bikerglen/pic24-dmx-rgb-led-dimmer/(list of files, cad)

Other CAD files:
mech/pic24-rgb-led-strip-tilt-bracket-v4.f3d
