bikerglen/pic24-dmx-rgb-led-dimmer/boards/open-din-rail-mount/pic24rgbdin-01.pdf

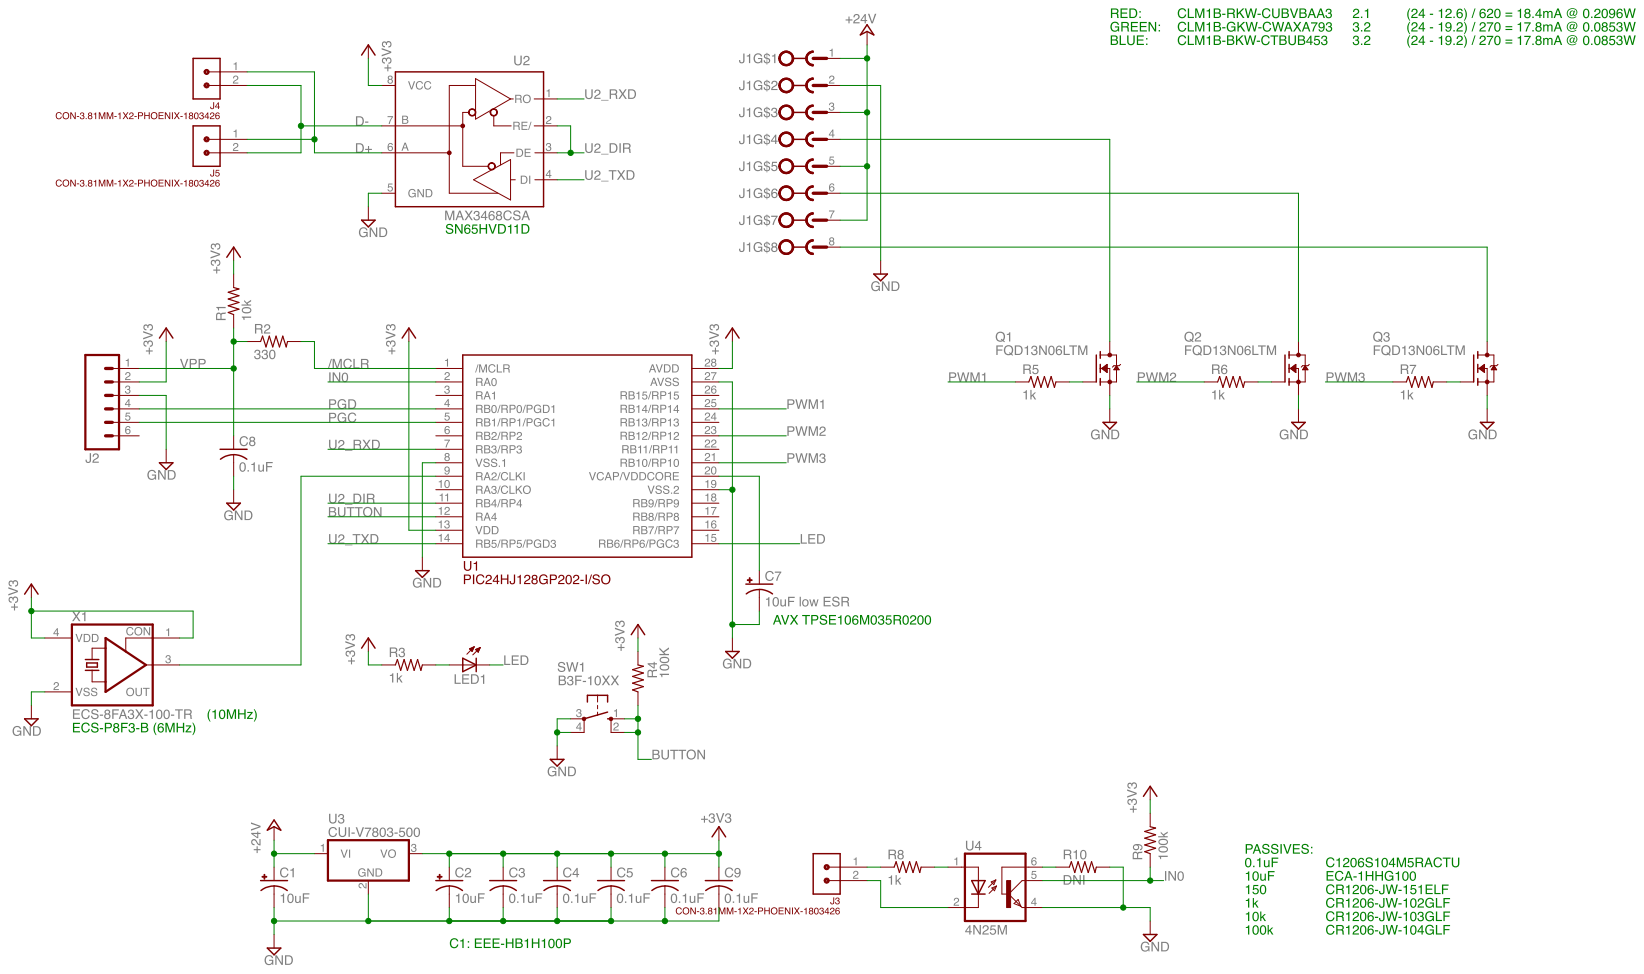
[picture p1: page 1]
