bikerglen/pic24-dmx-rgb-led-dimmer/boards/two-inch-round-v2/pic24rgbrnd01-r2b.brd

## EAGLE design boards/two-inch-round-v2/pic24rgbrnd01-r2b.brd (2019-03-25)

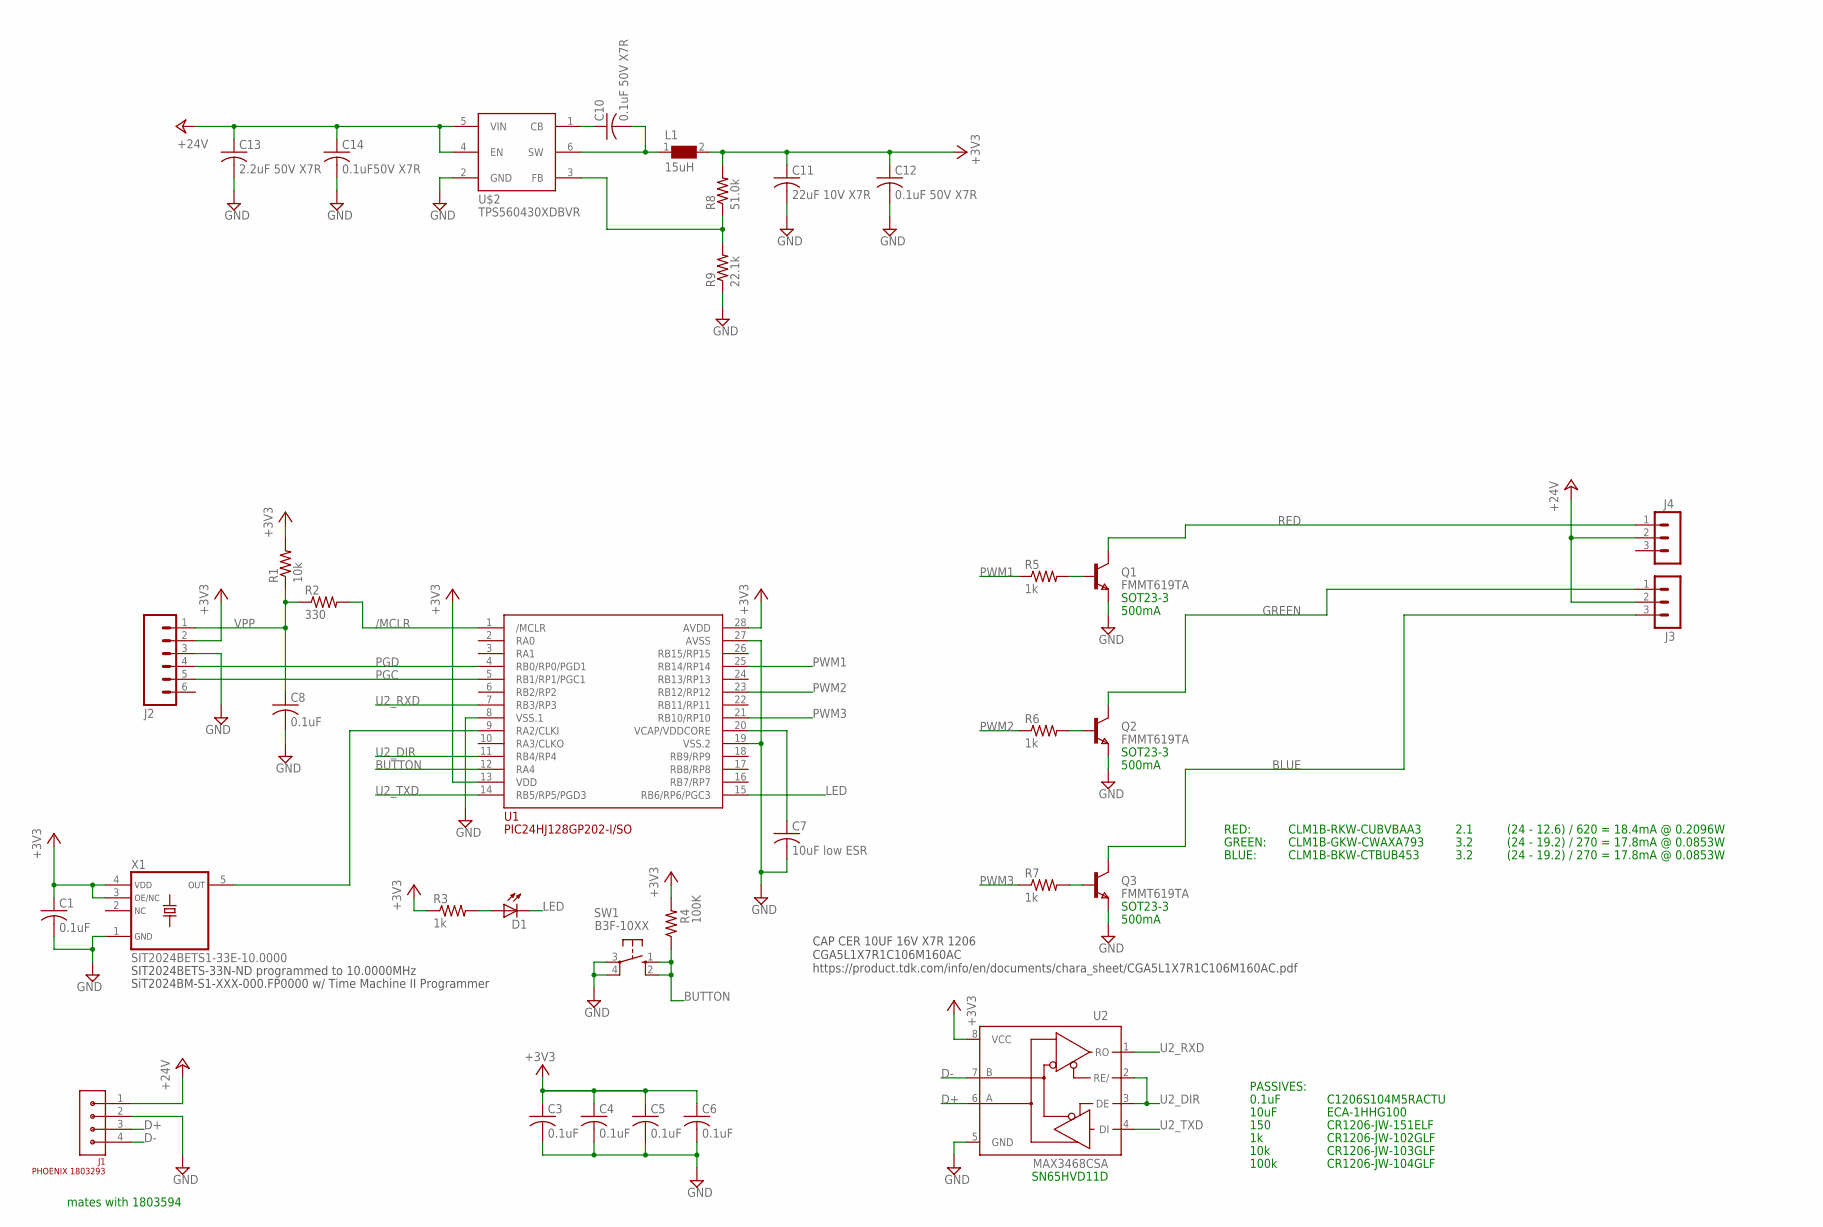
[picture p2: schematic pic24rgbrnd01-r2b.sch]

Parts:
C1, C3, C4, C5, C6, C8: 0.1uF; C0805
C7: 10uF low ESR; C1206
C10, C12: 0.1uF 50V X7R; C0805
C11: 22uF 10V X7R; C1206K; MFR_PART_NO C1206C226K8RAC7800
C13: 2.2uF 50V X7R; C1210K; MFR_PART_NO C1210C106K5RACTU
C14: 0.1uF50V X7R; C0805
D1: LED3MM
J1: PHOENIX 1803293; CON-PHOENIX-1803293-3.81-1X4
J2: M06SIP; 1X06
J3, J4: MA03-1
L1: 15uH; WE-SPC_48XX
Q1, Q2, Q3: FMMT619TA; SOT-23
R1: 10k; R0805
R2: 330; R0805
R3, R5, R6, R7: 1k; R0805
R4: 100K; R0805
R8: 51.0k; R0805
R9: 22.1k; R0805
SW1: B3F-10XX
U1: PIC24HJ128GP202-I/SO; SO28W
U2: MAX3468CSA; SO08
U$2: TPS560430XDBVR; SOT23-6
X1: SIT2024BETS1-33E-10.0000; SOT23-5

Connections:
+3V3: C1.1, C3.1, C4.1, C5.1, C6.1, C11.1, C12.1, J2.2, L1.2, R1.2, R3.1, R4.2, R8.2, U1.13 (VDD), U1.28 (AVDD), U2.8 (VCC), X1.3 (OE/NC), X1.4 (VDD)
+24V: C13.1, C14.1, J1.1, J3.2, J4.2, U$2.4 (EN), U$2.5 (VIN)
/MCLR: R2.2, U1.1 (/MCLR)
BLUE: J3.3, Q3.1 (C)
BUTTON: R4.1, SW1.1 (S), SW1.2 (S1), U1.12 (RA4)
CB: C10.1, U$2.1 (CB)
D+: J1.3, U2.6 (A)
D-: J1.4, U2.7 (B)
FB: R8.1, R9.2, U$2.3 (FB)
GND: C1.2, C3.2, C4.2, C5.2, C6.2, C7.2, C8.2, C11.2, C12.2, C13.2, C14.2, J1.2, J2.3, Q1.2 (E), Q2.2 (E), Q3.2 (E), R9.1, SW1.3, SW1.4 (P1), U1.8 (VSS.1), U1.19 (VSS.2), U1.27 (AVSS), U2.5 (GND), U$2.2 (GND), X1.1 (GND)
GREEN: J3.1, Q2.1 (C)
LED: D1.K (C), U1.15 (RB6/RP6/PGC3)
unnamed: C7.1, U1.20 (VCAP/VDDCORE)
unnamed: U1.9 (RA2/CLKI), X1.5 (OUT)
unnamed: Q1.3 (B), R5.2
unnamed: Q2.3 (B), R6.2
unnamed: Q3.3 (B), R7.2
unnamed: D1.A, R3.2
PGC: J2.5, U1.5 (RB1/RP1/PGC1)
PGD: J2.4, U1.4 (RB0/RP0/PGD1)
PWM1: R5.1, U1.25 (RB14/RP14)
PWM2: R6.1, U1.23 (RB12/RP12)
PWM3: R7.1, U1.21 (RB10/RP10)
RED: J4.1, Q1.1 (C)
SW: C10.2, L1.1, U$2.6 (SW)
U2_DIR: U1.11 (RB4/RP4), U2.2 (RE/), U2.3 (DE)
U2_RXD: U1.7 (RB3/RP3), U2.1 (RO)
U2_TXD: U1.14 (RB5/RP5/PGD3), U2.4 (DI)
VPP: C8.1, J2.1, R1.1, R2.1

Notes on the sheet:
SN65HVD11D
0.1uF
C1206S104M5RACTU
150
10k
100k
CR1206-JW-102GLF
CR1206-JW-151ELF
CR1206-JW-104GLF
CR1206-JW-103GLF
PASSIVES:
10uF
ECA-1HHG100
SOT23-3
500mA
RED:
CLM1B-RKW-CUBVBAA3
2.1
GREEN:
CLM1B-GKW-CWAXA793
3.2
BLUE:
CLM1B-BKW-CTBUB453
(24 - 12.6) / 620 = 18.4mA @ 0.2096W
(24 - 19.2) / 270 = 17.8mA @ 0.0853W
mates with 1803594
CAP CER 10UF 16V X7R 1206 CGA5L1X7R1C106M160AC https://product.tdk.com/info/en/documents/chara_sheet/CGA5L1X7R1C106M160AC.pdf
SIT2024BETS-33N-ND programmed to 10.0000MHz
SiT2024BM-S1-XXX-000.FP0000 w/ Time Machine II Programmer

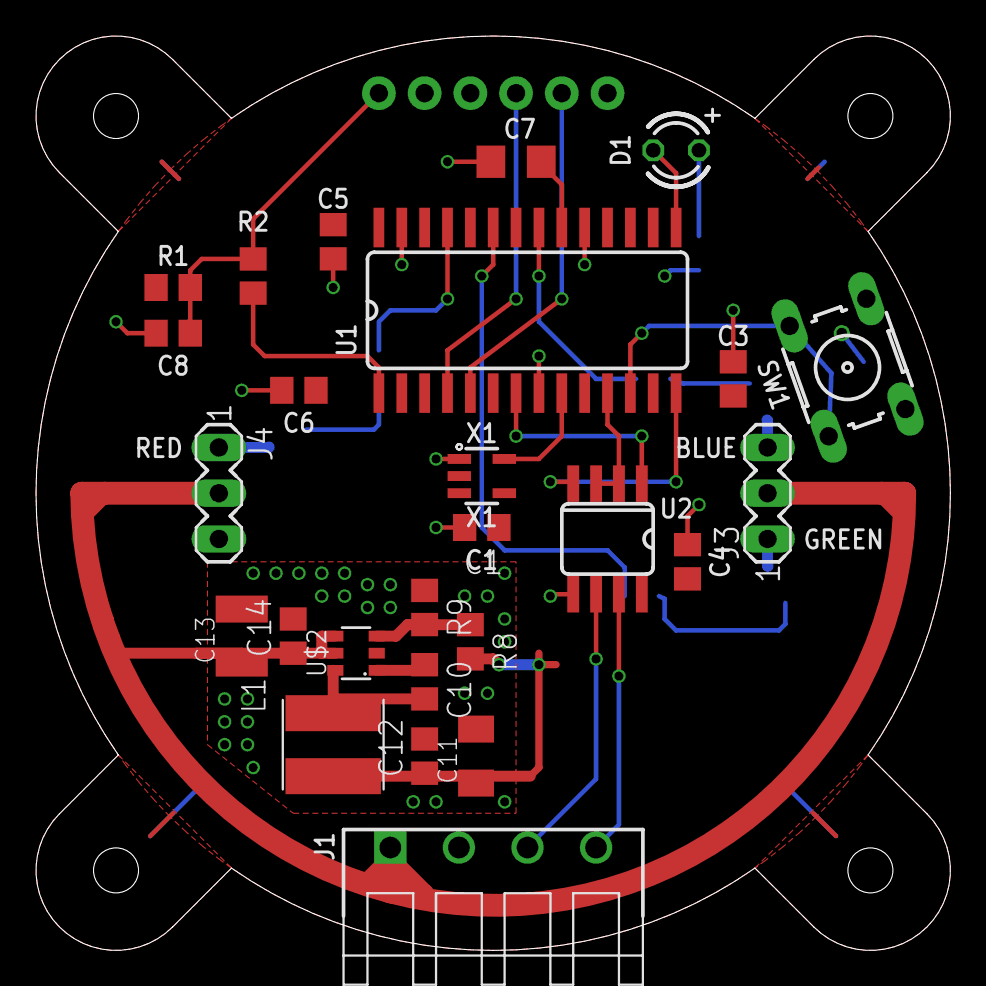
[picture p3: board pic24rgbrnd01-r2b.brd from above]

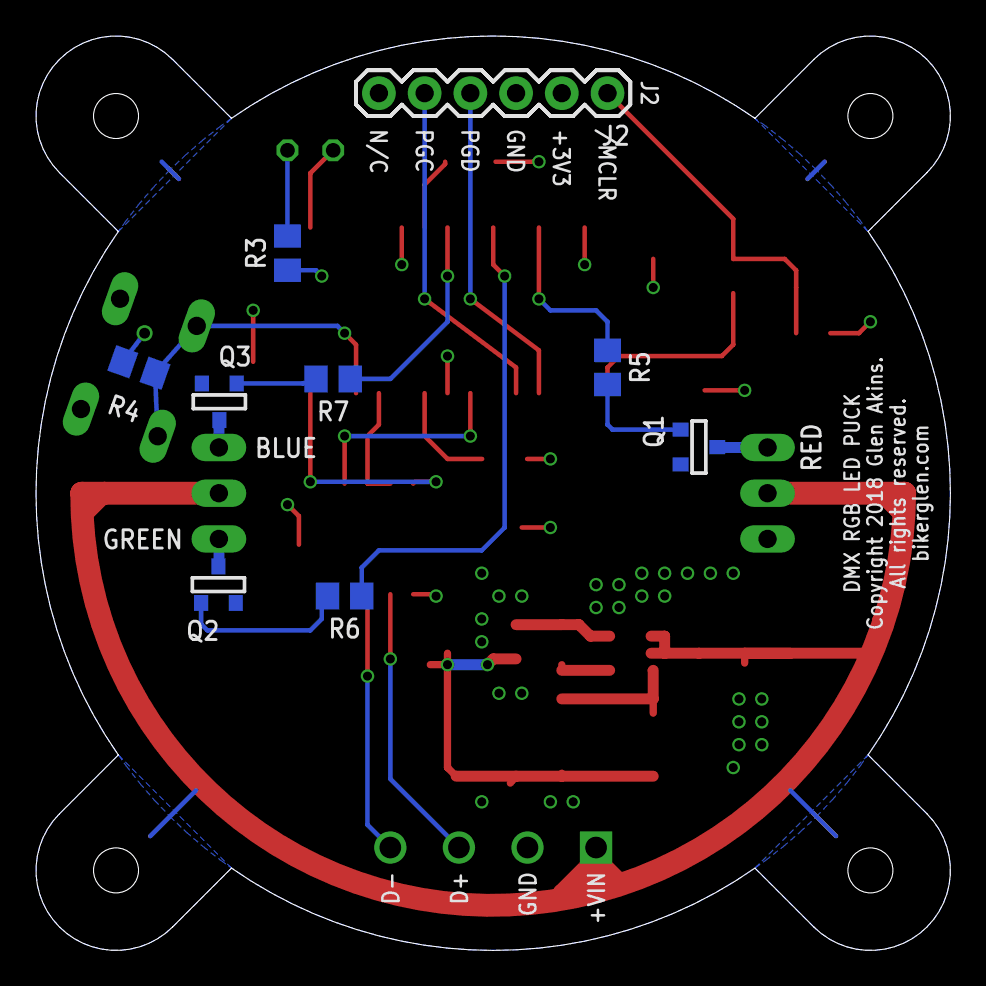
[picture p4: board pic24rgbrnd01-r2b.brd from below]

Board: 2 copper layers, 50.8 x 50.8 mm, 35 parts (9 on the bottom side), 29 nets.
