bikerglen/pic24-dmx-rgb-led-dimmer/boards/open-din-rail-mount/pic24rgbdin-01.brd

## EAGLE design boards/open-din-rail-mount/pic24rgbdin-01.brd (2017-12-12)

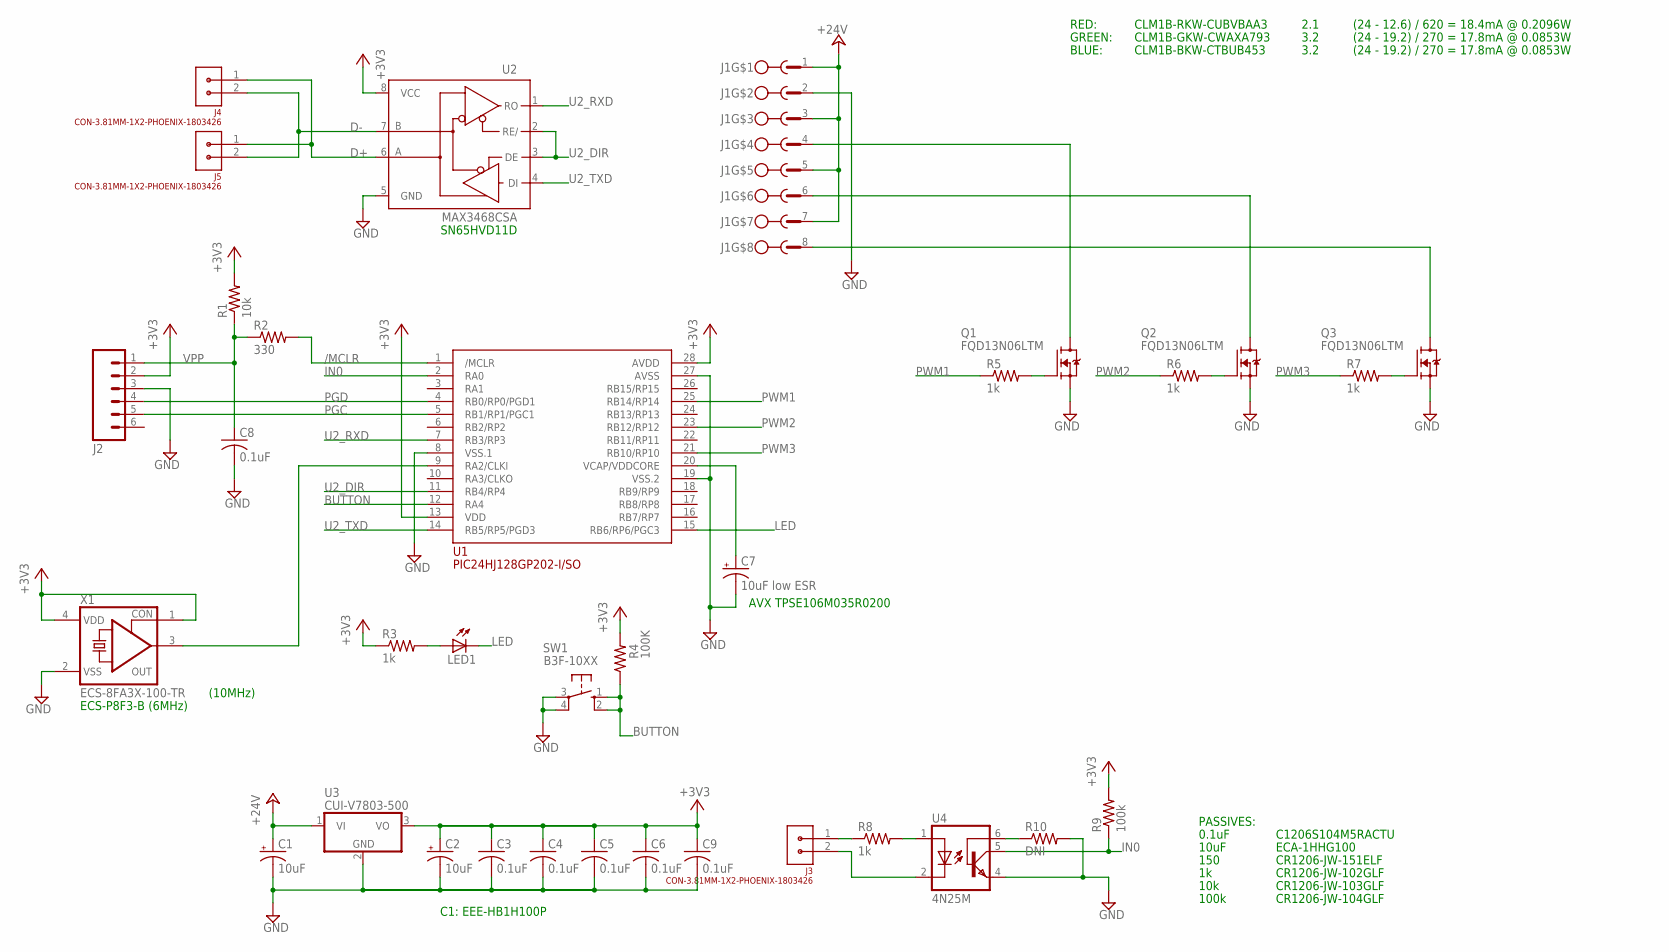
[picture p5: schematic pic24rgbdin-01.sch]

Parts:
C1, C2: 10uF; PANASONIC_D
C3, C4, C5, C6, C8, C9: 0.1uF; C1206
C7: 10uF low ESR; D/7343-31R
J1: CON-3.81MM-1X8-PHOENIX-HEADER-1803484; CON-PHOENIX-1803484-3.81-1X8
J2: M06SIP; 1X06
J3, J4, J5: CON-3.81MM-1X2-PHOENIX-1803426; CON-PHOENIX-1803426-3.81-1X2
LED1: LED3MM
Q1, Q2, Q3: FQD13N06LTM; TO252-D-PAK-FQD13N06LTM
R1: 10k; R1206
R2: 330; R1206
R3, R5, R6, R7, R8: 1k; R1206
R4: 100K; M1206
R9: 100k; R1206
R10: DNI; R1206
SW1: B3F-10XX
U1: PIC24HJ128GP202-I/SO; SO28W
U2: MAX3468CSA; SO08
U3: CUI-V7803-500; CUI-78XX-500
U4: 4N25M; DIL06
X1: ECS-8FA3X-100-TR; 1100S

Connections:
+3V3: C2.+, C3.1, C4.1, C5.1, C6.1, C9.1, J2.2, R1.2, R3.1, R4.2, R9.2, U1.13 (VDD), U1.28 (AVDD), U2.8 (VCC), U3.3 (VO), X1.1 (CON), X1.4 (VDD)
+24V: C1.+, J1.1, J1.3, J1.5, J1.7, U3.1 (VI)
/MCLR: R2.2, U1.1 (/MCLR)
BLUE: J1.8, Q3.P$4 (D)
BUTTON: R4.1, SW1.1 (S), SW1.2 (S1), U1.12 (RA4)
D+: J4.1, J5.1, U2.6 (A)
D-: J4.2, J5.2, U2.7 (B)
GND: C1.-, C2.-, C3.2, C4.2, C5.2, C6.2, C7.-, C8.2, C9.2, J1.2, J2.3, Q1.P$3 (S), Q2.P$3 (S), Q3.P$3 (S), R10.2, SW1.3, SW1.4 (P1), U1.8 (VSS.1), U1.19 (VSS.2), U1.27 (AVSS), U2.5 (GND), U3.2 (GND), U4.4 (EMI), X1.2 (VSS)
GREEN: J1.6, Q2.P$4 (D)
IN0: R9.1, U1.2 (RA0), U4.5 (COL)
LED: LED1.K (C), U1.15 (RB6/RP6/PGC3)
unnamed: Q2.P$1 (G), R6.2
unnamed: Q3.P$1 (G), R7.2
unnamed: R8.2, U4.1 (A)
unnamed: C7.+, U1.20 (VCAP/VDDCORE)
unnamed: U1.9 (RA2/CLKI), X1.3 (OUT)
unnamed: R10.1, U4.6 (BAS)
unnamed: J3.2, U4.2 (C)
unnamed: J3.1, R8.1
unnamed: Q1.P$1 (G), R5.2
unnamed: LED1.A, R3.2
PGC: J2.5, U1.5 (RB1/RP1/PGC1)
PGD: J2.4, U1.4 (RB0/RP0/PGD1)
PWM1: R5.1, U1.25 (RB14/RP14)
PWM2: R6.1, U1.23 (RB12/RP12)
PWM3: R7.1, U1.21 (RB10/RP10)
RED: J1.4, Q1.P$4 (D)
U2_DIR: U1.11 (RB4/RP4), U2.2 (RE/), U2.3 (DE)
U2_RXD: U1.7 (RB3/RP3), U2.1 (RO)
U2_TXD: U1.14 (RB5/RP5/PGD3), U2.4 (DI)
VPP: C8.1, J2.1, R1.1, R2.1

Notes on the sheet:
(10MHz)
ECS-P8F3-B (6MHz)
SN65HVD11D
C1: EEE-HB1H100P
0.1uF
C1206S104M5RACTU
150
10k
100k
CR1206-JW-102GLF
CR1206-JW-151ELF
CR1206-JW-104GLF
CR1206-JW-103GLF
PASSIVES:
10uF
ECA-1HHG100
RED:
CLM1B-RKW-CUBVBAA3
2.1
GREEN:
CLM1B-GKW-CWAXA793
3.2
BLUE:
CLM1B-BKW-CTBUB453
(24 - 12.6) / 620 = 18.4mA @ 0.2096W
(24 - 19.2) / 270 = 17.8mA @ 0.0853W
AVX TPSE106M035R0200

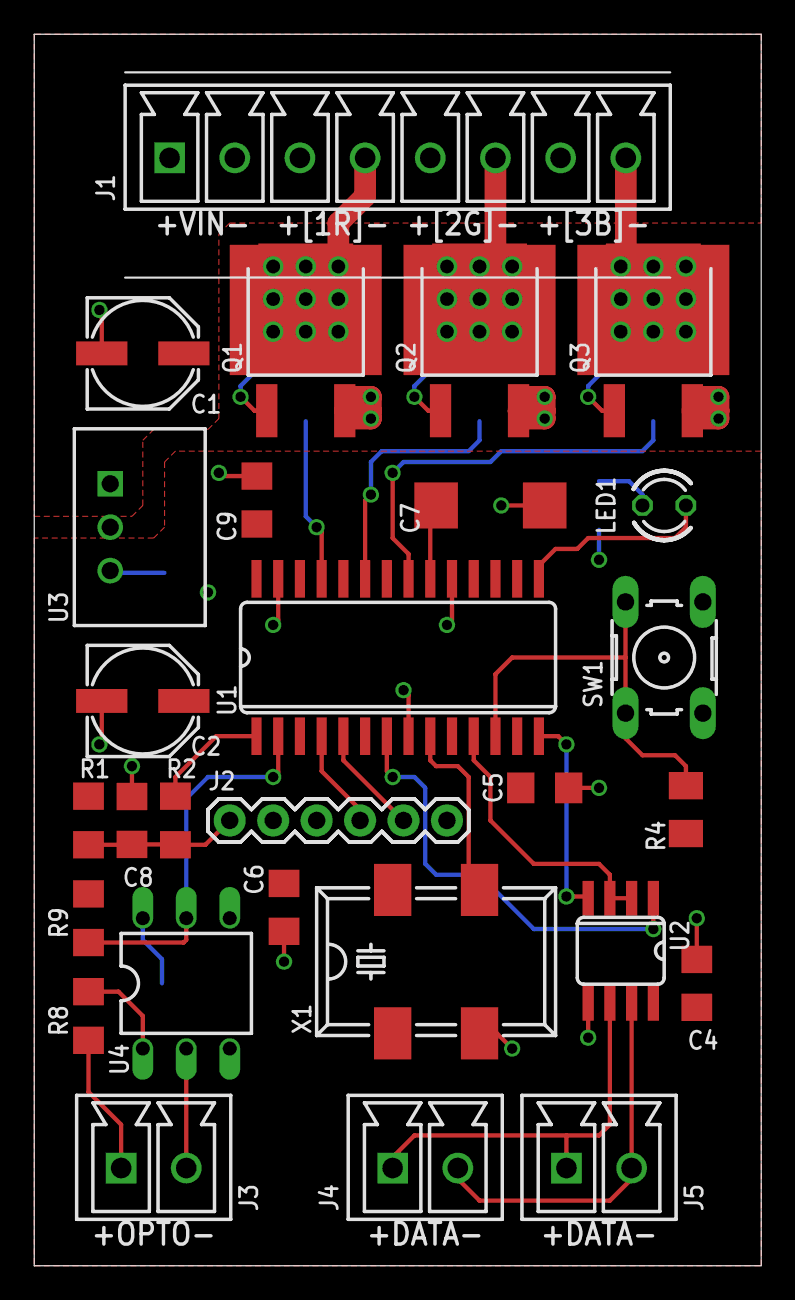
[picture p6: board pic24rgbdin-01.brd from above]

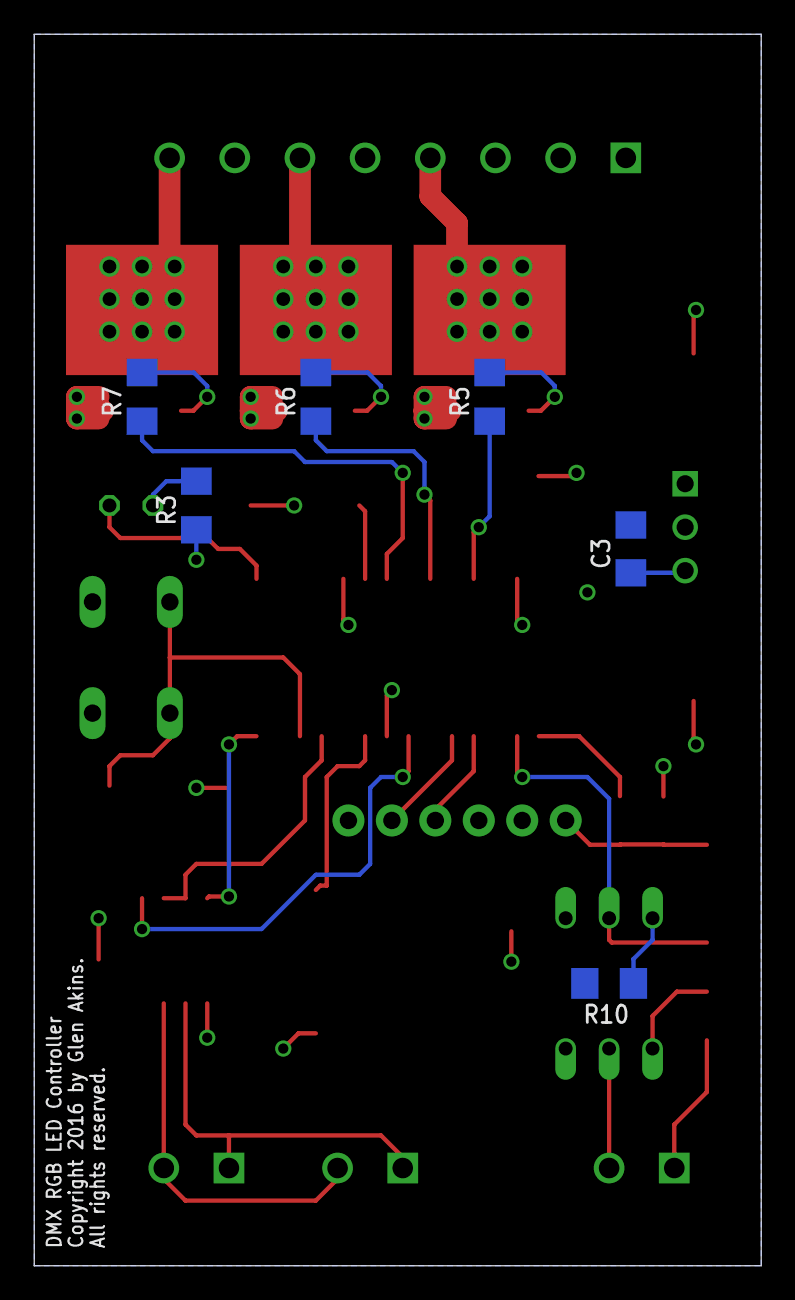
[picture p7: board pic24rgbdin-01.brd from below]

Board: 2 copper layers, 42.5 x 72.0 mm, 34 parts (6 on the bottom side), 31 nets.
