bikerglen/pic24-dmx-rgb-led-dimmer/(commit log)

2017-12-12 initial checkin
    [pic24rgbdin-01.brd, pic24rgbdin-01.sch]
2019-03-25 initial checkin of v2 round boards
    [pic24rgbrnd01-r2b.brd, pic24rgbrnd01-r2b.sch]
