bikerglen/pic24-dmx-rgb-led-dimmer/(notices)

Notices in the files:
boards/two-inch-round/pic24rgbrnd01-r1.brd:
Copyright 2016 Glen Akins.
boards/six-inch-strip/pic24rgb01-r3.brd:
Copyright 2016 by Glen Akins.
boards/two-inch-round-v2/pic24rgbrnd01-r2b.brd:
Copyright 2018 Glen Akins.
parts and their libraries:
SparkFun-Connectors: Licensing: Creative Commons ShareAlike 4.0 International - https://creativecommons.org/licenses/by-sa/4.0
